ichimei/LED-digital-clock/poster.jpg

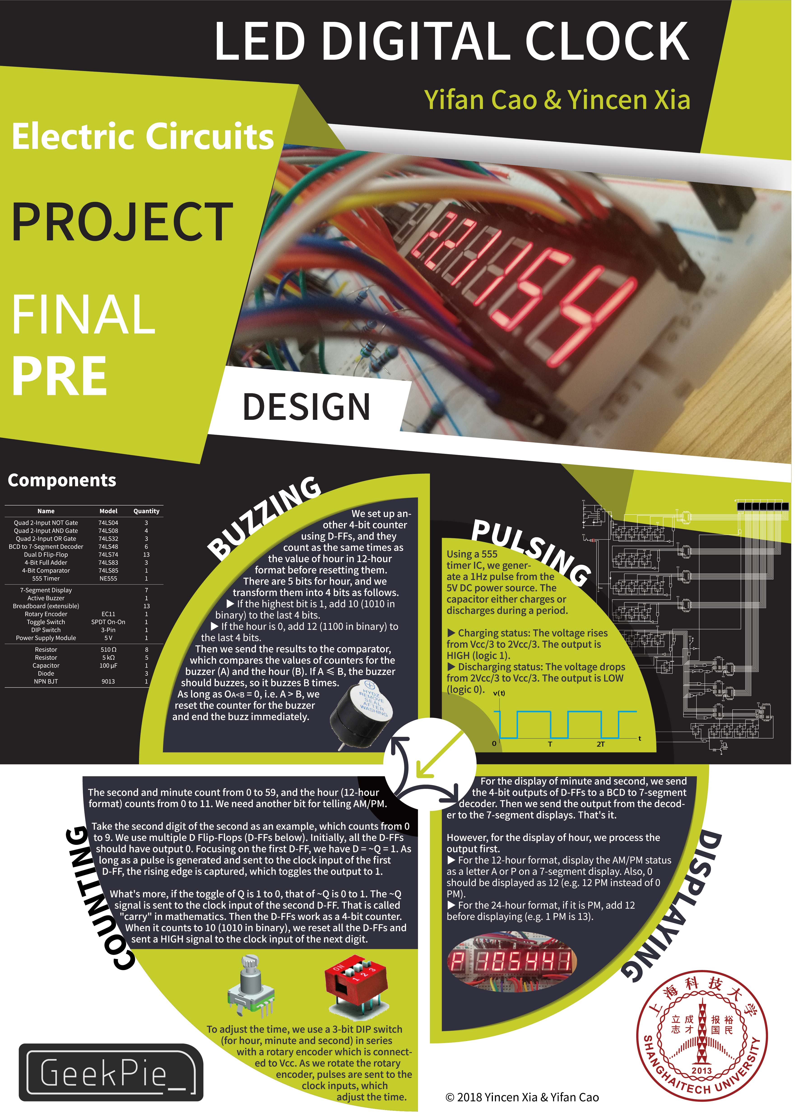
poster.jpg
