ichimei/LED-digital-clock/practical.jpg

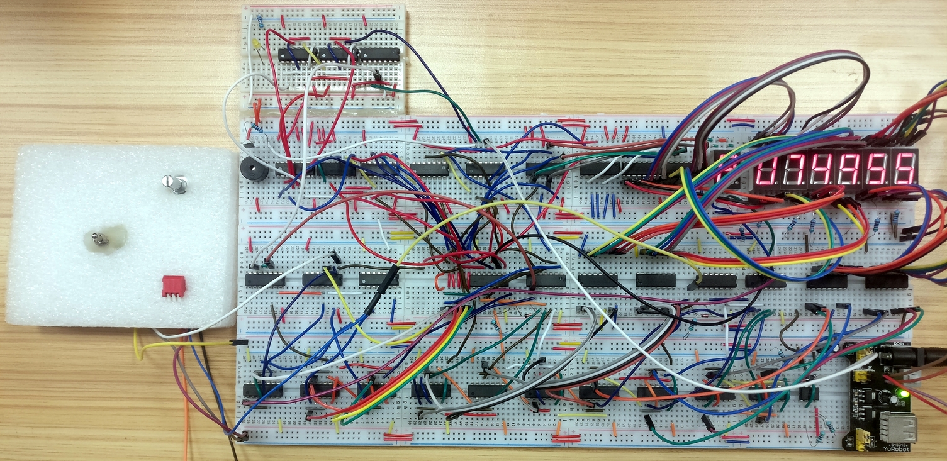
practical.jpg
