ichimei/LED-digital-clock/README.md

# LED-digital-clock
Multisim and practical design of an LED digital clock. Electric Circuits (EE111) course project.
