ichimei/LED-digital-clock/(list of files, drawings)

Other design files:
simulation.ms14
